umedoblock/freq-counter/pcb/images/freq-counter-pcb-pre-final.png

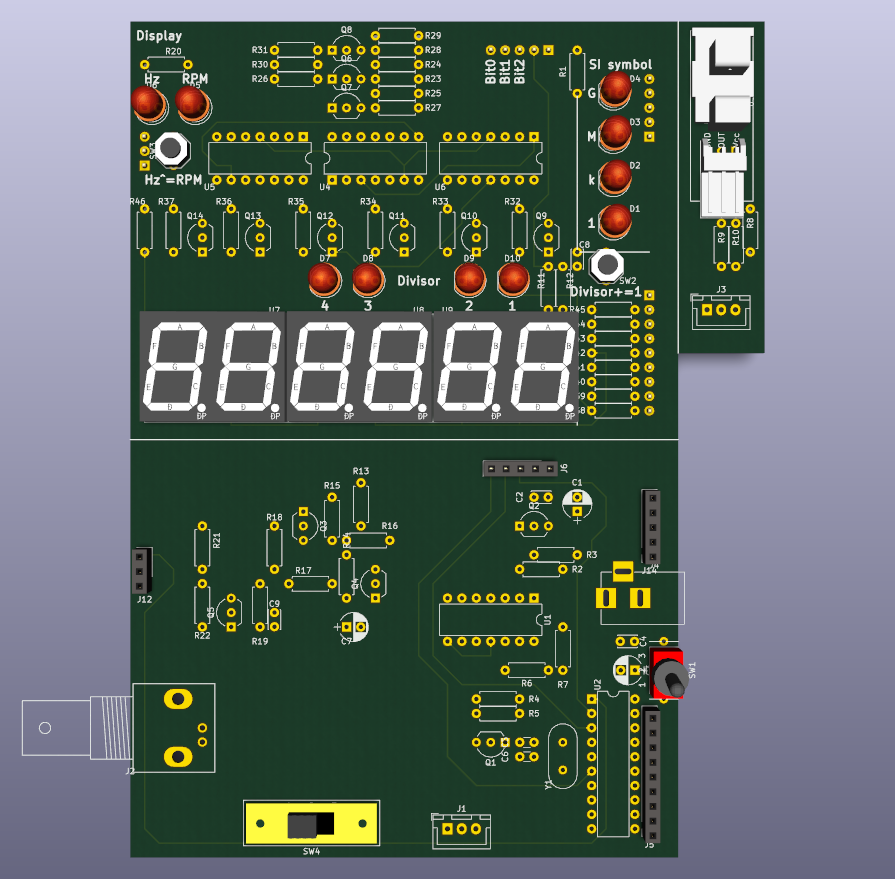
pcb/images/freq-counter-pcb-pre-final.png
