umedoblock/freq-counter/pcb/images/real-board-and-kicad-board.png

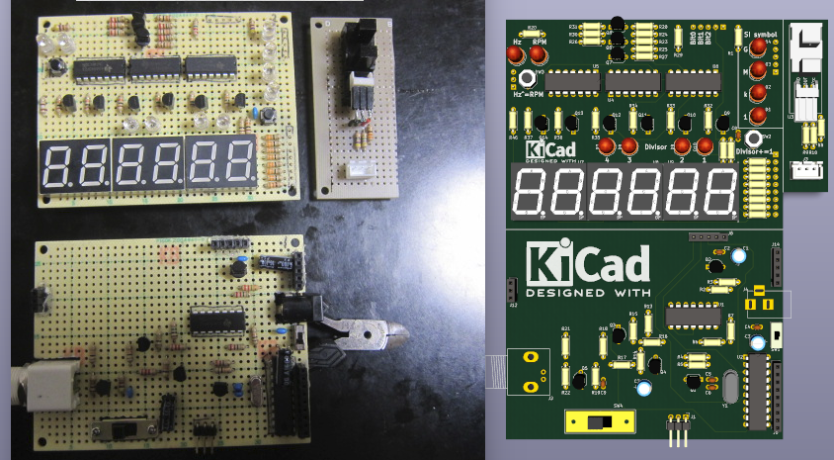
pcb/images/real-board-and-kicad-board.png
