umedoblock/freq-counter/README.md

# freq-counter
frequency counter with Attiny4313
