umedoblock/freq-counter/pcb/images/freq-counter-pcb-completed.png

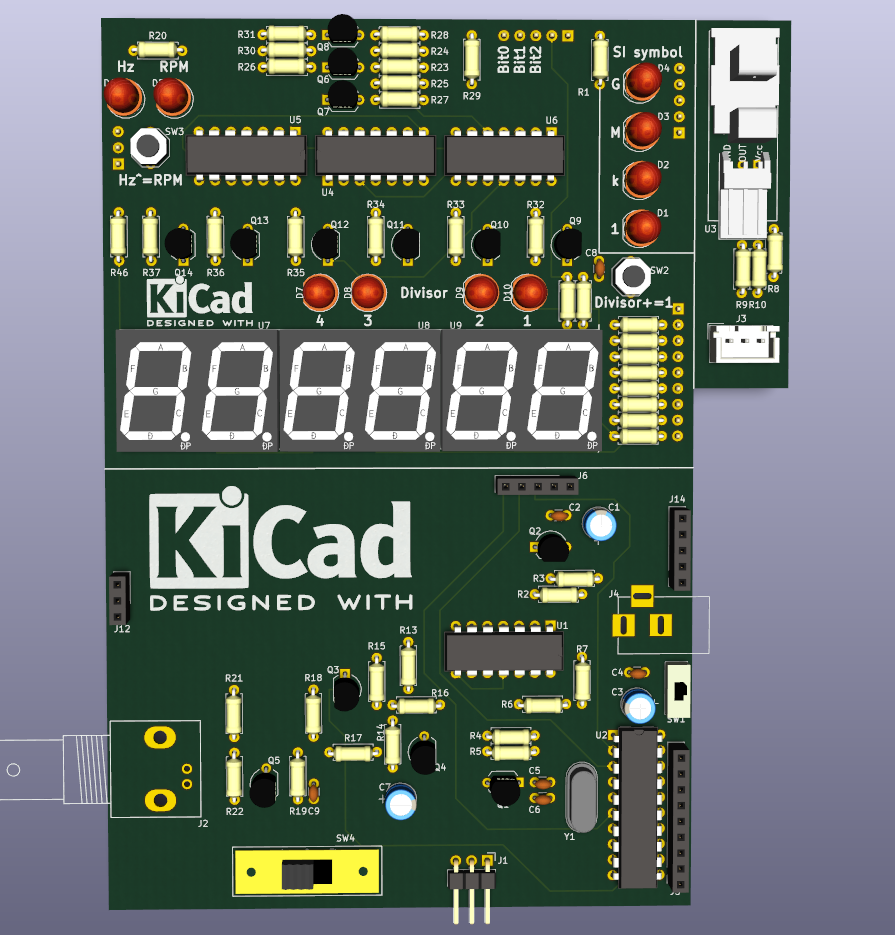
pcb/images/freq-counter-pcb-completed.png
