umedoblock/freq-counter/pcb/images/freq-counter-pcb-plain.png

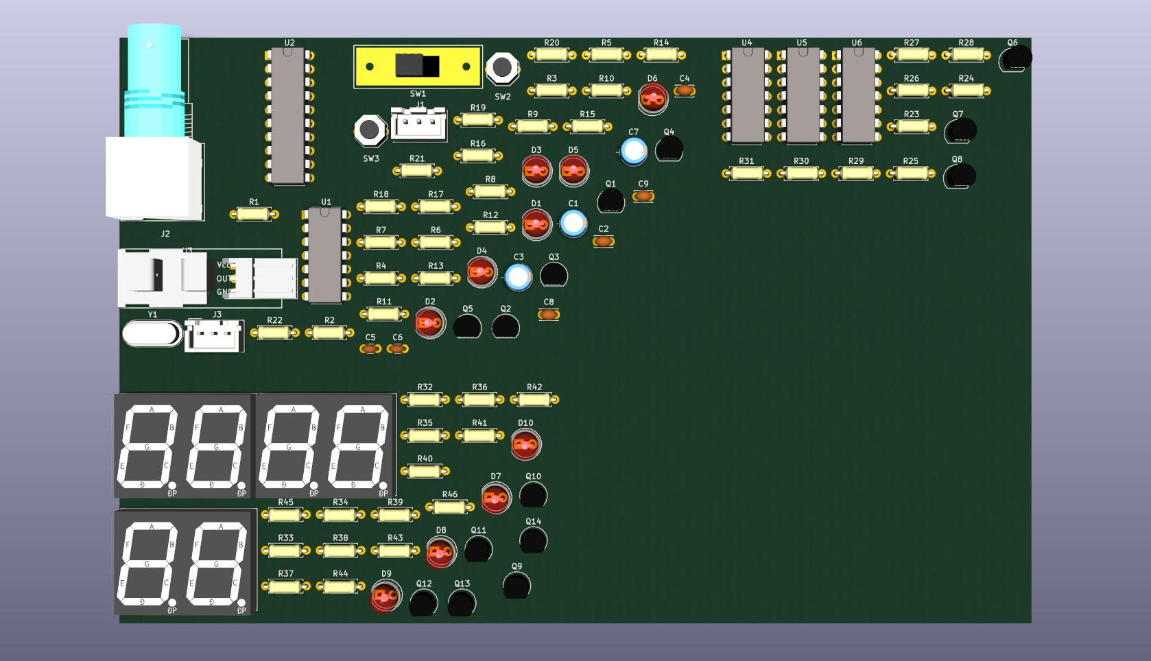
pcb/images/freq-counter-pcb-plain.png
