umedoblock/freq-counter/pcb/freq-counter.ods

Reference | Value | Footprint | Datasheet
C1 | 100u | Capacitor_THT:CP_Radial_D5.0mm_P2.50mm
C2 | 0.1u | Capacitor_THT:C_Disc_D3.0mm_W1.6mm_P2.50mm
C3 | 100u | Capacitor_THT:CP_Radial_D5.0mm_P2.50mm
C4 | 0.1u | Capacitor_THT:C_Disc_D3.0mm_W1.6mm_P2.50mm
C5 | 22p | Capacitor_THT:C_Disc_D3.0mm_W1.6mm_P2.50mm
C6 | 22p | Capacitor_THT:C_Disc_D3.0mm_W1.6mm_P2.50mm
C7 | 4.7u | Capacitor_THT:CP_Radial_D5.0mm_P2.50mm
C8 | 0.1u | Capacitor_THT:C_Disc_D3.0mm_W1.6mm_P2.50mm
C9 | 0.1u | Capacitor_THT:C_Disc_D3.0mm_W1.6mm_P2.50mm
D1 | 1 | LED_THT:LED_D5.0mm
D2 | k | LED_THT:LED_D5.0mm
D3 | M | LED_THT:LED_D5.0mm
D4 | G | LED_THT:LED_D5.0mm
D5 | RPM | LED_THT:LED_D5.0mm
D6 | Hz | LED_THT:LED_D5.0mm
D7 | 4 | LED_THT:LED_D5.0mm
D8 | 3 | LED_THT:LED_D5.0mm
D9 | 2 | LED_THT:LED_D5.0mm
D10 | 1 | LED_THT:LED_D5.0mm
J1 | RPM on board | Connector_PinHeader_2.54mm:PinHeader_1x03_P2.54mm_Horizontal
J2 | BNC | Connectors_TE-Connectivity:BNC_Socket_TYCO-AMP
J3 | RPM to Board | Connector_JST:JST_XH_B03B-XH-A_1x03_P2.50mm_Horizontal
J4 | Jack-DC | Connectors:BARREL_JACK
J5 | Segments-Terminal0 | Connector_PinSocket_2.54mm:PinSocket_1x09_P2.54mm_Vertical
J6 | Power-Digits_Terminal0 | Connector_PinSocket_2.54mm:PinSocket_1x05_P2.54mm_Vertical
J7 | Segments-Terminal1 | Connector_PinHeader_2.54mm:PinHeader_1x09_P2.54mm_Vertical
J8 | Power-Digits_Terminal1 | Connector_PinHeader_2.54mm:PinHeader_1x05_P2.54mm_Vertical
J11 | Hz/RPM_Terminal1 | Connector_PinHeader_2.54mm:PinHeader_1x03_P2.54mm_Vertical
J12 | Hz/RPM_Terminal0 | Connector_PinSocket_2.54mm:PinSocket_1x03_P2.54mm_Vertical
J13 | 1kMG_Terminal1 | Connector_PinHeader_2.54mm:PinHeader_1x05_P2.54mm_Vertical
J14 | 1kMG_Terminal0 | Connector_PinSocket_2.54mm:PinSocket_1x05_P2.54mm_Vertical
Q1 | CSC388A | TO_SOT_Packages_THT:TO-92_Inline_Wide
Q2 | CSC388A | TO_SOT_Packages_THT:TO-92_Inline_Wide
Q3 | 2SA1015 | TO_SOT_Packages_THT:TO-92_Inline_Wide
Q4 | 2SC1815 | TO_SOT_Packages_THT:TO-92_Inline_Wide
Q5 | 2SC1815 | TO_SOT_Packages_THT:TO-92_Inline_Wide
Q6 | CSC388A | TO_SOT_Packages_THT:TO-92_Inline_Wide
Q7 | CSC388A | TO_SOT_Packages_THT:TO-92_Inline_Wide
Q8 | CSC388A | TO_SOT_Packages_THT:TO-92_Inline_Wide
Q9 | 2SC1815 | TO_SOT_Packages_THT:TO-92_Inline_Wide
Q10 | 2SC1815 | TO_SOT_Packages_THT:TO-92_Inline_Wide
Q11 | 2SC1815 | TO_SOT_Packages_THT:TO-92_Inline_Wide
Q12 | 2SC1815 | TO_SOT_Packages_THT:TO-92_Inline_Wide
Q13 | 2SC1815 | TO_SOT_Packages_THT:TO-92_Inline_Wide
Q14 | 2SC1815 | TO_SOT_Packages_THT:TO-92_Inline_Wide
R1 | 470 | Resistors_THT:R_Axial_DIN0207_L6.3mm_D2.5mm_P7.62mm_Horizontal
R2 | 2.2M | Resistors_THT:R_Axial_DIN0207_L6.3mm_D2.5mm_P7.62mm_Horizontal
R3 | 2.2M | Resistors_THT:R_Axial_DIN0207_L6.3mm_D2.5mm_P7.62mm_Horizontal
R4 | 2.2M | Resistors_THT:R_Axial_DIN0207_L6.3mm_D2.5mm_P7.62mm_Horizontal
R5 | 10k | Resistors_THT:R_Axial_DIN0207_L6.3mm_D2.5mm_P7.62mm_Horizontal
R6 | 2.2M | Resistors_THT:R_Axial_DIN0207_L6.3mm_D2.5mm_P7.62mm_Horizontal
R7 | 10k | Resistors_THT:R_Axial_DIN0207_L6.3mm_D2.5mm_P7.62mm_Horizontal
R8 | 330 | Resistors_THT:R_Axial_DIN0207_L6.3mm_D2.5mm_P7.62mm_Horizontal
R9 | 47k | Resistors_THT:R_Axial_DIN0207_L6.3mm_D2.5mm_P7.62mm_Horizontal
R10 | 4.7M | Resistors_THT:R_Axial_DIN0207_L6.3mm_D2.5mm_P7.62mm_Horizontal
R11 | 100k | Resistors_THT:R_Axial_DIN0207_L6.3mm_D2.5mm_P7.62mm_Horizontal
R12 | 10k | Resistors_THT:R_Axial_DIN0207_L6.3mm_D2.5mm_P7.62mm_Horizontal
R13 | 1M | Resistors_THT:R_Axial_DIN0207_L6.3mm_D2.5mm_P7.62mm_Horizontal
R14 | 47k | Resistors_THT:R_Axial_DIN0207_L6.3mm_D2.5mm_P7.62mm_Horizontal
R15 | 100k | Resistors_THT:R_Axial_DIN0207_L6.3mm_D2.5mm_P7.62mm_Horizontal
R16 | 2.2k | Resistors_THT:R_Axial_DIN0207_L6.3mm_D2.5mm_P7.62mm_Horizontal
R17 | 2.2k | Resistors_THT:R_Axial_DIN0207_L6.3mm_D2.5mm_P7.62mm_Horizontal
R18 | 10k | Resistors_THT:R_Axial_DIN0207_L6.3mm_D2.5mm_P7.62mm_Horizontal
R19 | 4.7k | Resistors_THT:R_Axial_DIN0207_L6.3mm_D2.5mm_P7.62mm_Horizontal
R20 | 470 | Resistors_THT:R_Axial_DIN0207_L6.3mm_D2.5mm_P7.62mm_Horizontal
R21 | 10k | Resistors_THT:R_Axial_DIN0207_L6.3mm_D2.5mm_P7.62mm_Horizontal
R22 | 10k | Resistors_THT:R_Axial_DIN0207_L6.3mm_D2.5mm_P7.62mm_Horizontal
R23 | 10k | Resistors_THT:R_Axial_DIN0207_L6.3mm_D2.5mm_P7.62mm_Horizontal
R24 | 2.2M | Resistors_THT:R_Axial_DIN0207_L6.3mm_D2.5mm_P7.62mm_Horizontal
R25 | 2.2M | Resistors_THT:R_Axial_DIN0207_L6.3mm_D2.5mm_P7.62mm_Horizontal
R26 | 2.2M | Resistors_THT:R_Axial_DIN0207_L6.3mm_D2.5mm_P7.62mm_Horizontal
R27 | 10k | Resistors_THT:R_Axial_DIN0207_L6.3mm_D2.5mm_P7.62mm_Horizontal
R28 | 10k | Resistors_THT:R_Axial_DIN0207_L6.3mm_D2.5mm_P7.62mm_Horizontal
R29 | 2.2M | Resistors_THT:R_Axial_DIN0207_L6.3mm_D2.5mm_P7.62mm_Horizontal
R30 | 2.2M | Resistors_THT:R_Axial_DIN0207_L6.3mm_D2.5mm_P7.62mm_Horizontal
R31 | 2.2M | Resistors_THT:R_Axial_DIN0207_L6.3mm_D2.5mm_P7.62mm_Horizontal
R32 | 10k | Resistors_THT:R_Axial_DIN0207_L6.3mm_D2.5mm_P7.62mm_Horizontal
R33 | 10k | Resistors_THT:R_Axial_DIN0207_L6.3mm_D2.5mm_P7.62mm_Horizontal
R34 | 10k | Resistors_THT:R_Axial_DIN0207_L6.3mm_D2.5mm_P7.62mm_Horizontal
R35 | 10k | Resistors_THT:R_Axial_DIN0207_L6.3mm_D2.5mm_P7.62mm_Horizontal
R36 | 10k | Resistors_THT:R_Axial_DIN0207_L6.3mm_D2.5mm_P7.62mm_Horizontal
R37 | 10k | Resistors_THT:R_Axial_DIN0207_L6.3mm_D2.5mm_P7.62mm_Horizontal
R38 | 330 | Resistors_THT:R_Axial_DIN0207_L6.3mm_D2.5mm_P7.62mm_Horizontal
R39 | 33 | Resistors_THT:R_Axial_DIN0207_L6.3mm_D2.5mm_P7.62mm_Horizontal
R40 | 33 | Resistors_THT:R_Axial_DIN0207_L6.3mm_D2.5mm_P7.62mm_Horizontal
R41 | 33 | Resistors_THT:R_Axial_DIN0207_L6.3mm_D2.5mm_P7.62mm_Horizontal
R42 | 33 | Resistors_THT:R_Axial_DIN0207_L6.3mm_D2.5mm_P7.62mm_Horizontal
R43 | 33 | Resistors_THT:R_Axial_DIN0207_L6.3mm_D2.5mm_P7.62mm_Horizontal
R44 | 33 | Resistors_THT:R_Axial_DIN0207_L6.3mm_D2.5mm_P7.62mm_Horizontal
R45 | 33 | Resistors_THT:R_Axial_DIN0207_L6.3mm_D2.5mm_P7.62mm_Horizontal
R46 | 180 | Resistors_THT:R_Axial_DIN0207_L6.3mm_D2.5mm_P7.62mm_Horizontal
SW1 | on/off | freq-counter:SS12D01G4
SW2 | count up | freq-counter:TVDT18-tactile-switch
SW3 | toggle | freq-counter:TVDT18-tactile-switch
SW4 | SW_SIGNAL | freq-counter:Slide-switch-x2
U1 | SN74HC02N | Package_DIP:DIP-14_W7.62mm
U2 | ATTINY4313-PU(freq-counter) | Package_DIP:DIP-20_W7.62mm
U3 | EE-SX460 | freq-counter:EE-SX460-P1
U4 | 74HC00 | Package_DIP:DIP-14_W7.62mm
U5 | 74HC00 | Package_DIP:DIP-14_W7.62mm
U6 | 74HC00 | Package_DIP:DIP-14_W7.62mm
U7 | 7seg-2digit-ca | freq-counter:PARA_LIGHT-552SRD
U8 | 7seg-2digit-ca | freq-counter:PARA_LIGHT-552SRD
U9 | 7seg-2digit-ca | freq-counter:PARA_LIGHT-552SRD
Y1 | 20MHz | Crystal:Crystal_HC49-4H_Vertical
