umedoblock/freq-counter/pcb/freq-counter.kicad_pcb

## KiCad design pcb/freq-counter.kicad_pcb (2017-12-02)

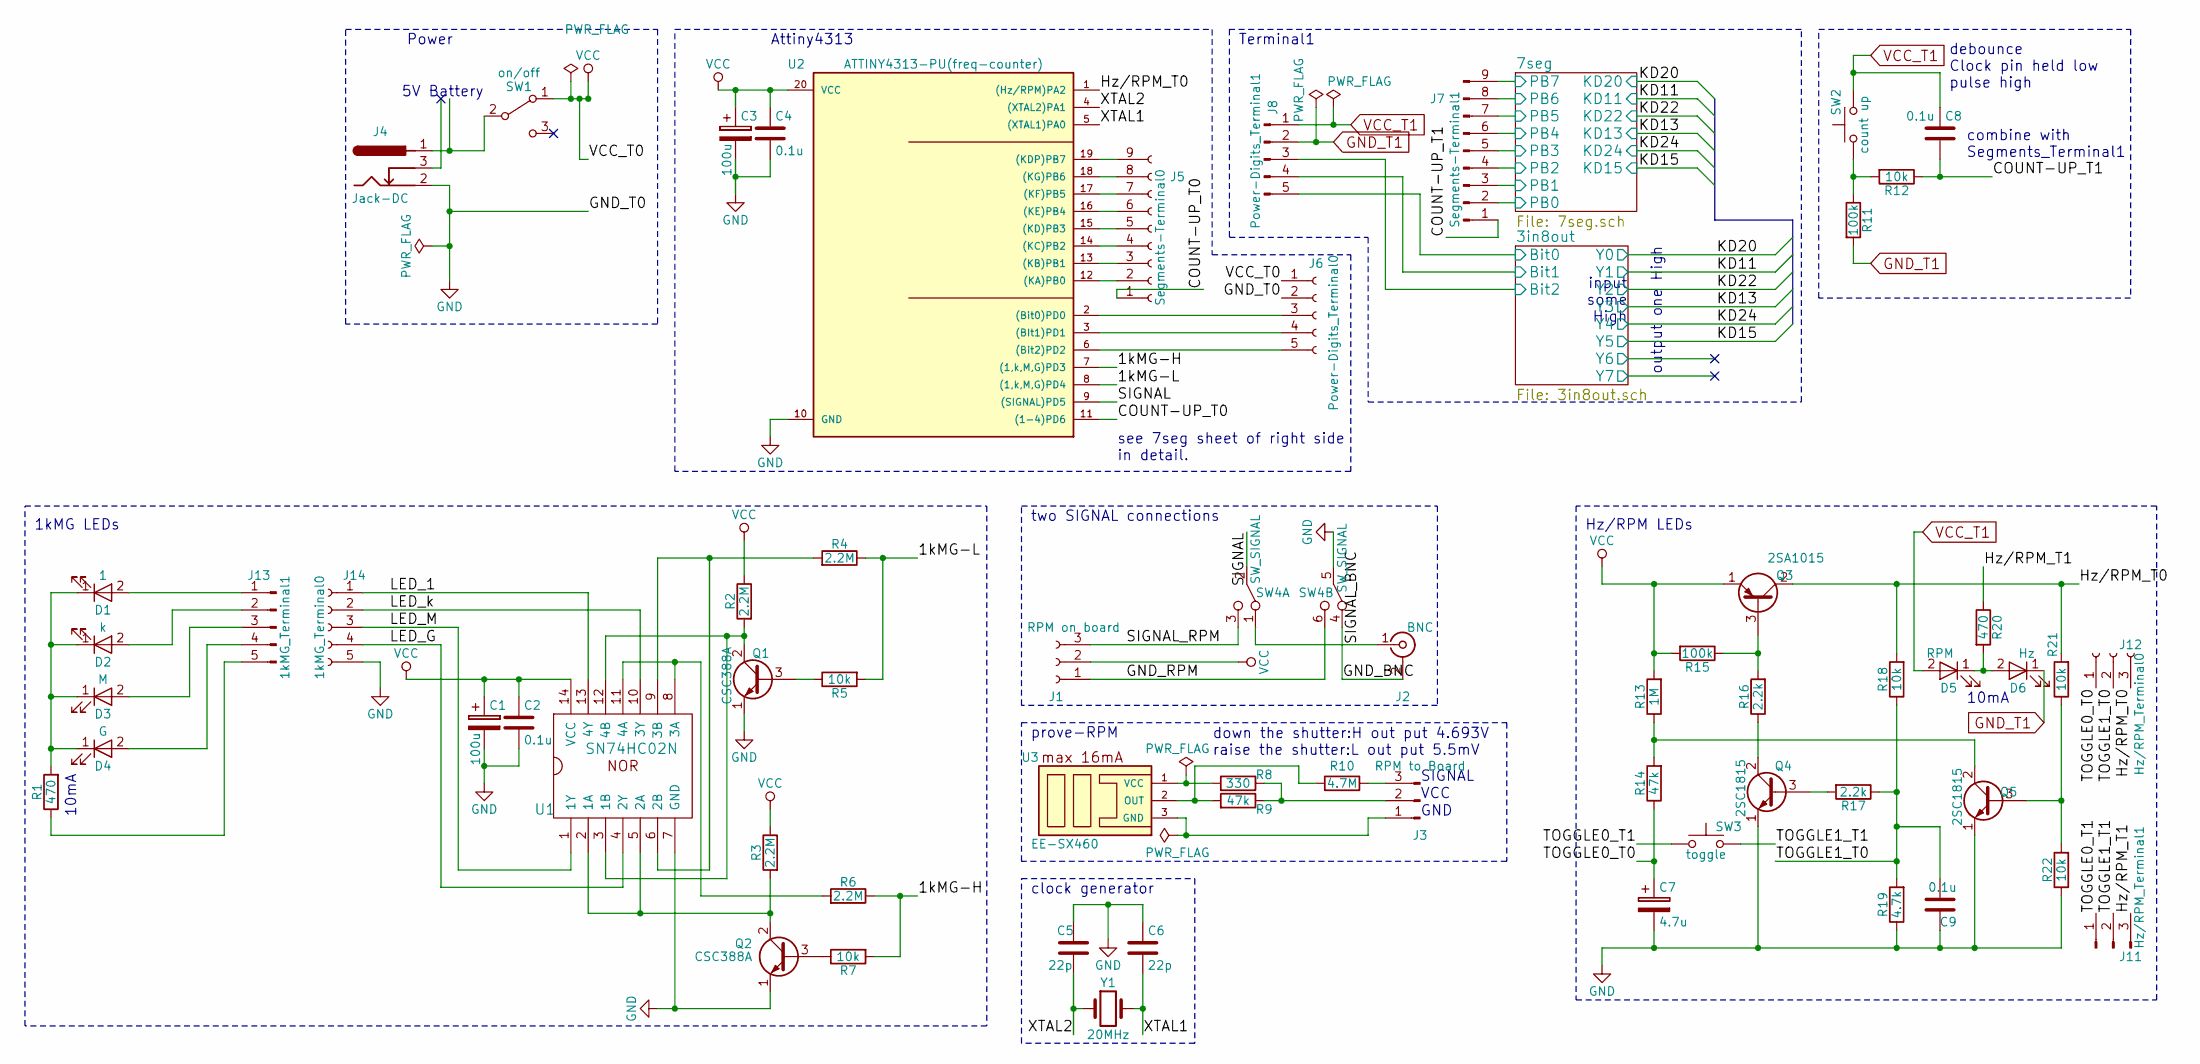
[picture p5: schematic freq-counter.sch]

Parts:
C1, C3: 100u; CP_Radial_D5.0mm_P2.50mm
C2, C4, C8, C9: 0.1u; C_Disc_D3.0mm_W1.6mm_P2.50mm
C5, C6: 22p; C_Disc_D3.0mm_W1.6mm_P2.50mm
C7: 4.7u; CP_Radial_D5.0mm_P2.50mm
D1: 1; LED_D5.0mm
D2: k; LED_D5.0mm
D3: M; LED_D5.0mm
D4: G; LED_D5.0mm
D5: RPM; LED_D5.0mm
D6: Hz; LED_D5.0mm
J1: RPM on board; PinHeader_1x03_P2.54mm_Horizontal
J2: BNC; BNC_Socket_TYCO-AMP
J3: RPM to Board; JST_XH_B03B-XH-A_03x2.50mm_Straight
J4: Jack-DC; BARREL_JACK
J5: Segments-Terminal0; PinSocket_1x09_P2.54mm_Vertical
J6: Power-Digits_Terminal0; PinSocket_1x05_P2.54mm_Vertical
J7: Segments-Terminal1; PinHeader_1x09_P2.54mm_Vertical
J8: Power-Digits_Terminal1; PinHeader_1x05_P2.54mm_Vertical
J11: Hz/RPM_Terminal1; PinHeader_1x03_P2.54mm_Vertical
J12: Hz/RPM_Terminal0; PinSocket_1x03_P2.54mm_Vertical
J13: 1kMG_Terminal1; PinHeader_1x05_P2.54mm_Vertical
J14: 1kMG_Terminal0; PinSocket_1x05_P2.54mm_Vertical
Q1, Q2: CSC388A; TO-92_Inline_Wide
Q3: 2SA1015; TO-92_Inline_Wide
Q4, Q5: 2SC1815; TO-92_Inline_Wide
R1, R20: 470; R_Axial_DIN0207_L6.3mm_D2.5mm_P7.62mm_Horizontal
R2, R3, R4, R6: 2.2M; R_Axial_DIN0207_L6.3mm_D2.5mm_P7.62mm_Horizontal
R5, R7, R12, R18, R21, R22: 10k; R_Axial_DIN0207_L6.3mm_D2.5mm_P7.62mm_Horizontal
R8: 330; R_Axial_DIN0207_L6.3mm_D2.5mm_P7.62mm_Horizontal
R9, R14: 47k; R_Axial_DIN0207_L6.3mm_D2.5mm_P7.62mm_Horizontal
R10: 4.7M; R_Axial_DIN0207_L6.3mm_D2.5mm_P7.62mm_Horizontal
R11, R15: 100k; R_Axial_DIN0207_L6.3mm_D2.5mm_P7.62mm_Horizontal
R13: 1M; R_Axial_DIN0207_L6.3mm_D2.5mm_P7.62mm_Horizontal
R16, R17: 2.2k; R_Axial_DIN0207_L6.3mm_D2.5mm_P7.62mm_Horizontal
R19: 4.7k; R_Axial_DIN0207_L6.3mm_D2.5mm_P7.62mm_Horizontal
SW1: on/off; SS12D01G4
SW2: count up; TVDT18-tactile-switch
SW3: toggle; TVDT18-tactile-switch
SW4: SW_SIGNAL; Slide-switch-x2
U1: SN74HC02N; DIP-14_W7.62mm
U2: ATTINY4313-PU(freq-counter); DIP-20_W7.62mm
U3: EE-SX460; EE-SX460-P1
Y1: 20MHz; Crystal_HC49-4H_Vertical

Connections:
/1kMG-H: R6.1, R7.2, U2.7 ((1,k,M,G)PD3)
/1kMG-L: R4.1, R5.2, U2.8 ((1,k,M,G)PD4)
/3in8out/Bit0: J8.5; also elsewhere on the board
/3in8out/Bit1: J8.4; also elsewhere on the board
/3in8out/Bit2: J8.3; also elsewhere on the board
/7seg/PB0: J7.2; also elsewhere on the board
/7seg/PB1: J7.3; also elsewhere on the board
/7seg/PB2: J7.4; also elsewhere on the board
/7seg/PB3: J7.5; also elsewhere on the board
/7seg/PB4: J7.6; also elsewhere on the board
/7seg/PB5: J7.7; also elsewhere on the board
/7seg/PB6: J7.8; also elsewhere on the board
/7seg/PB7: J7.9; also elsewhere on the board
/COUNT-UP_T0: J5.1, U2.11 ((1-4)PD6)
/COUNT-UP_T1: C8.2, J7.1, R12.1
/GND_BNC: J2.2 (Ext), SW4.4 (A)
/GND_RPM: J1.1, SW4.6 (C)
/Hz/RPM_T0: J12.3, Q3.2 (C), R18.2, R21.2, U2.1 ((Hz/RPM)PA2)
/Hz/RPM_T1: J11.3, R20.1
/LED_1: J14.1, U1.13 (4Y)
/LED_G: J14.4, U1.4 (2Y)
/LED_M: J14.3, U1.1 (1Y)
/LED_k: J14.2, U1.10 (3Y)
/SIGNAL: SW4.2 (B), U2.9 ((SIGNAL)PD5)
/SIGNAL_BNC: J2.1 (In), SW4.1 (A)
/SIGNAL_RPM: J1.3, SW4.3 (C)
/TOGGLE0_T0: C7.1, J12.1, R14.1
/TOGGLE0_T1: J11.1, SW3.1
/TOGGLE1_T0: C9.2, J12.2, R17.1, R18.1, R19.2
/TOGGLE1_T1: J11.2, SW3.2
/XTAL1: C6.2, U2.5 ((XTAL1)PA0), Y1.2
/XTAL2: C5.2, U2.4 ((XTAL2)PA1), Y1.1
GND: C1.2, C2.2, C3.2, C4.2, C5.1, C6.1, C7.2, C9.1, J4.2, J6.2, J14.5, Q1.1 (E), Q2.1 (E), Q4.1 (E), Q5.1 (E), R19.1, R22.1, SW4.5 (B), U1.7 (GND), U2.10 (GND)
GND_T1: D6.1 (K), J8.2, R11.2; also elsewhere on the board
unnamed: D1.1 (K), D2.1 (K), D3.1 (K), D4.1 (K), R1.2
unnamed: D1.2 (A), J13.1
unnamed: D2.2 (A), J13.2
unnamed: D3.2 (A), J13.3
unnamed: D4.2 (A), J13.4
unnamed: D5.1 (K), D6.2 (A), R20.2
unnamed: J3.1, U3.3 (GND)
unnamed: J3.2, R8.1, R9.1
unnamed: J3.3, R10.1
unnamed: J4.1, SW1.2 (B)
unnamed: J5.2, U2.12 ((KA)PB0)
unnamed: J5.3, U2.13 ((KB)PB1)
unnamed: J5.4, U2.14 ((KC)PB2)
unnamed: J5.5, U2.15 ((KD)PB3)
unnamed: J5.6, U2.16 ((KE)PB4)
unnamed: J5.7, U2.17 ((KF)PB5)
unnamed: J5.8, U2.18 ((KG)PB6)
unnamed: J5.9, U2.19 ((KDP)PB7)
unnamed: J6.3, U2.2 ((Bit0)PD0)
unnamed: J6.4, U2.3 ((BIt1)PD1)
unnamed: J6.5, U2.6 ((Bit2)PD2)
unnamed: J13.5, R1.1
unnamed: Q1.2 (C), R2.2, U1.3 (1B), U1.12 (4B)
unnamed: Q1.3 (B), R5.1
unnamed: Q2.2 (C), R3.2, U1.2 (1A), U1.5 (2A)
unnamed: Q2.3 (B), R7.1
unnamed: Q3.3 (B), R15.1, R16.2
unnamed: Q4.2 (C), R16.1
unnamed: Q4.3 (B), R17.2
unnamed: Q5.2 (C), R13.1, R14.2
unnamed: Q5.3 (B), R21.1, R22.2
unnamed: R4.2, U1.6 (2B), U1.9 (3B)
unnamed: R6.2, U1.8 (3A), U1.11 (4A)
unnamed: R8.2, U3.1 (VCC)
unnamed: R9.2, R10.2, U3.2 (OUT)
unnamed: R11.1, R12.2, SW2.1
VCC: C1.1, C2.1, C3.1, C4.1, J1.2, J6.1, Q3.1 (E), R2.1, R3.1, R13.2, R15.2, SW1.1 (A), U1.14 (VCC), U2.20 (VCC)
VCC_T1: C8.1, D5.2 (A), J8.1, SW2.2; also elsewhere on the board

Notes on the sheet:
debounce Clock pin held low pulse high
Hz/RPM LEDs
1kMG LEDs
10mA
output one High
input some High
see 7seg sheet of right side in detail.
Attiny4313
clock generator
prove-RPM
two SIGNAL connections
SIGNAL
VCC
GND
down the shutter:H out put 4.693V raise the shutter:L out put 5.5mV
Power
5V Battery
Terminal1
combine with Segments_Terminal1

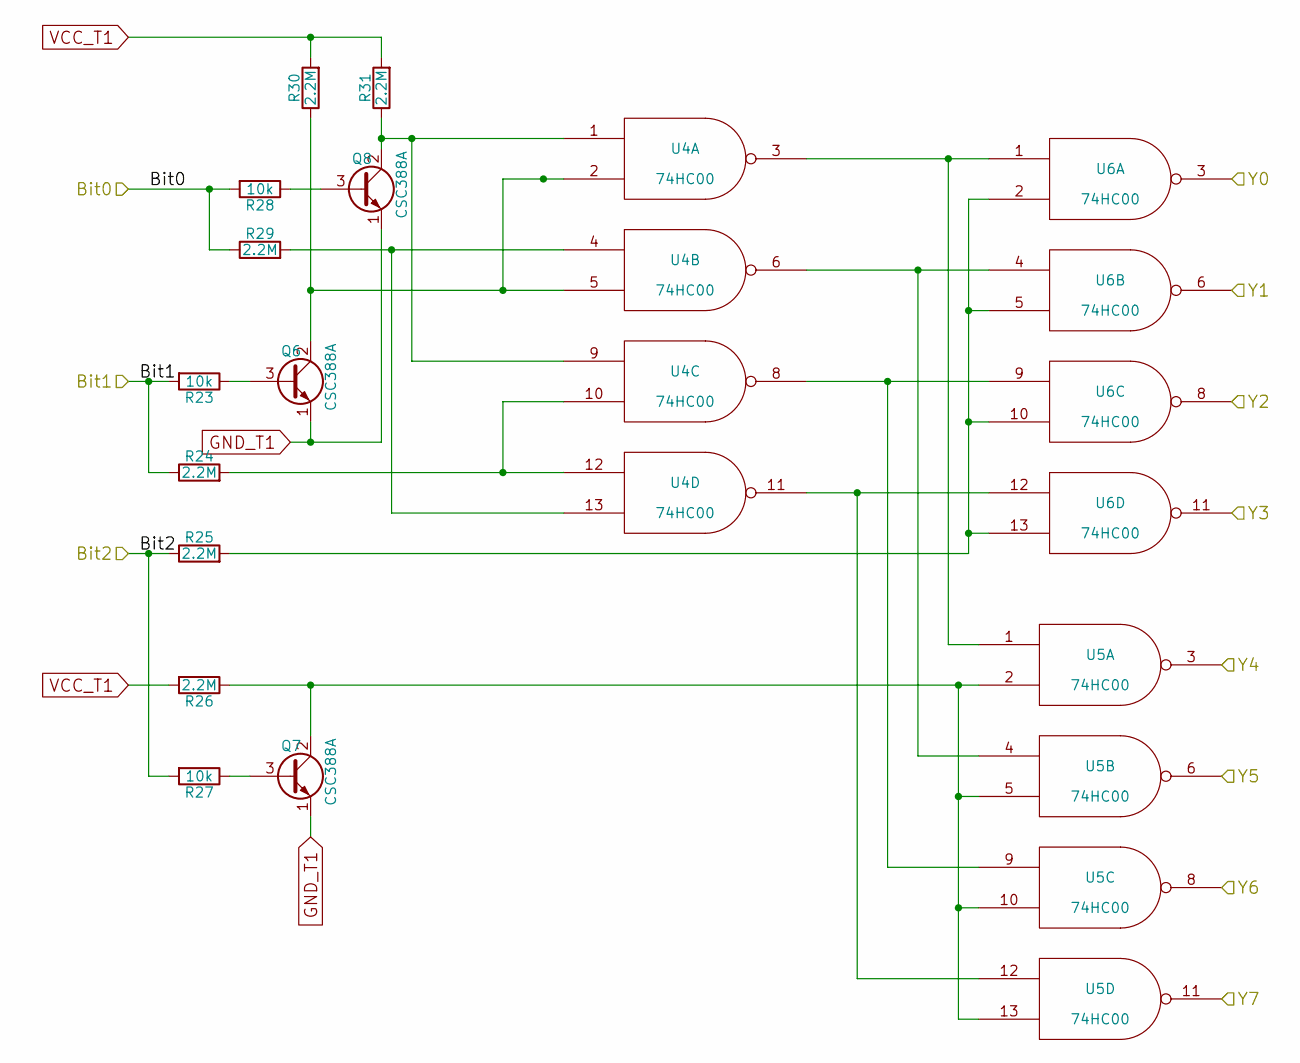
[picture p6: schematic 3in8out.sch]

Parts:
Q6, Q7, Q8: CSC388A; TO-92_Inline_Wide
R23, R27, R28: 10k; R_Axial_DIN0207_L6.3mm_D2.5mm_P7.62mm_Horizontal
R24, R25, R26, R29, R30, R31: 2.2M; R_Axial_DIN0207_L6.3mm_D2.5mm_P7.62mm_Horizontal
U4, U5, U6: 74HC00; DIP-14_W7.62mm

Connections:
/3in8out/Bit0: R28.2, R29.1; also elsewhere on the board
/3in8out/Bit1: R23.2, R24.1; also elsewhere on the board
/3in8out/Bit2: R25.1, R27.2; also elsewhere on the board
/KD11: U6.6; also elsewhere on the board
/KD13: U6.11; also elsewhere on the board
/KD15: U5.6; also elsewhere on the board
/KD20: U6.3; also elsewhere on the board
/KD22: U6.8; also elsewhere on the board
/KD24: U5.3; also elsewhere on the board
GND_T1: Q6.1 (E), Q7.1 (E), Q8.1 (E), U4.7 (GND_T1), U5.7 (GND_T1), U6.7 (GND_T1); also elsewhere on the board
unnamed: Q6.2 (C), R30.1, U4.2, U4.5
unnamed: Q6.3 (B), R23.1
unnamed: Q7.2 (C), R26.1, U5.2, U5.5, U5.10, U5.13
unnamed: Q7.3 (B), R27.1
unnamed: Q8.2 (C), R31.1, U4.1, U4.9
unnamed: Q8.3 (B), R28.1
unnamed: R24.2, U4.10, U4.12
unnamed: R25.2, U6.2, U6.5, U6.10, U6.13
unnamed: R29.2, U4.4, U4.13
unnamed: U4.3, U5.1, U6.1
unnamed: U4.6, U5.4, U6.4
unnamed: U4.8, U5.9, U6.9
unnamed: U4.11, U5.12, U6.12
VCC_T1: R26.2, R30.2, R31.2, U4.14 (VCC_T1), U5.14 (VCC_T1), U6.14 (VCC_T1); also elsewhere on the board

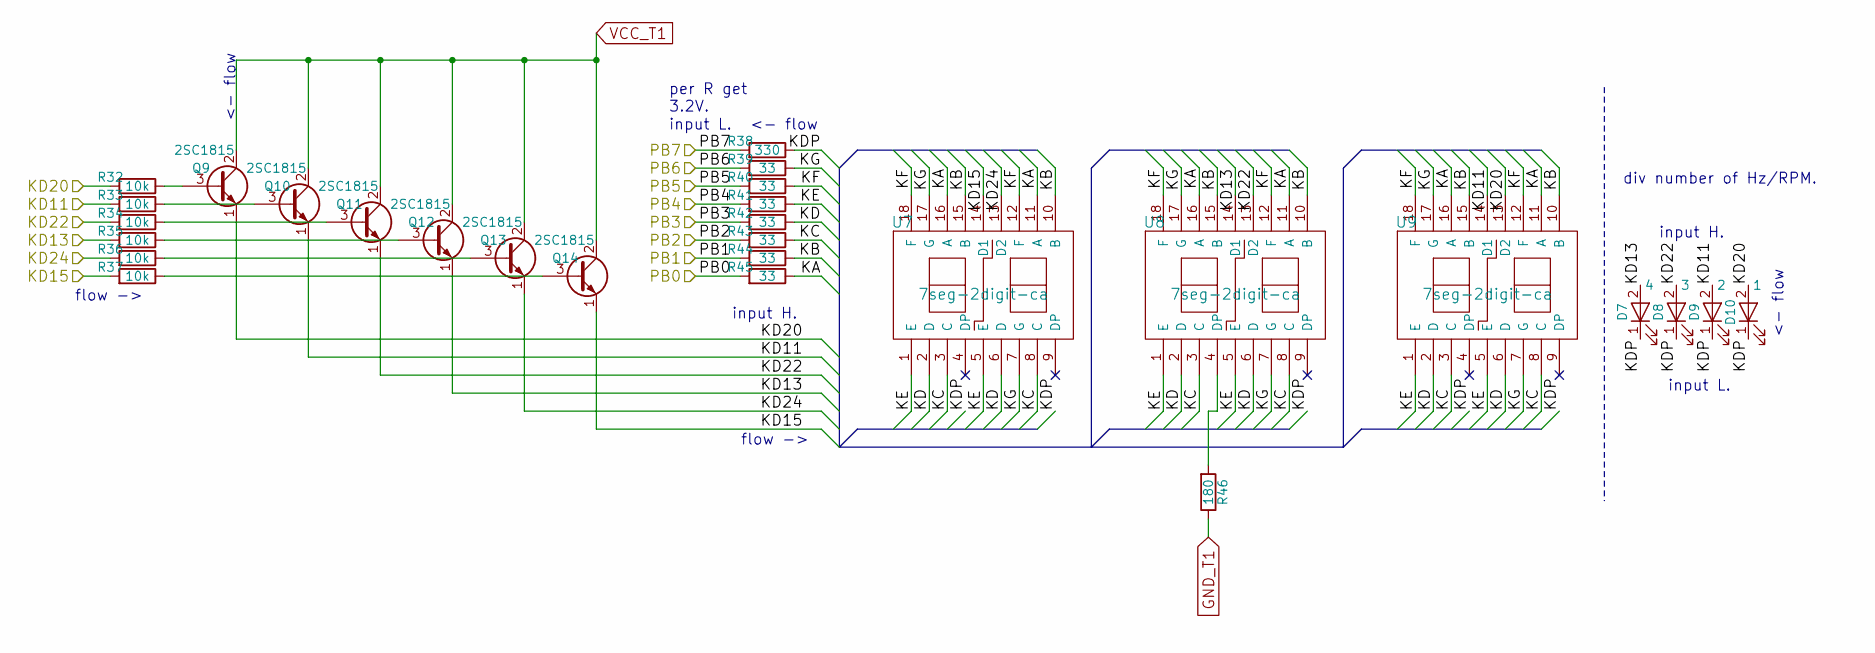
[picture p7: schematic 7seg.sch]

Parts:
D7: 4; LED_D5.0mm
D8: 3; LED_D5.0mm
D9: 2; LED_D5.0mm
D10: 1; LED_D5.0mm
Q9, Q10, Q11, Q12, Q13, Q14: 2SC1815; TO-92_Inline_Wide
R32, R33, R34, R35, R36, R37: 10k; R_Axial_DIN0207_L6.3mm_D2.5mm_P7.62mm_Horizontal
R38: 330; R_Axial_DIN0207_L6.3mm_D2.5mm_P7.62mm_Horizontal
R39, R40, R41, R42, R43, R44, R45: 33; R_Axial_DIN0207_L6.3mm_D2.5mm_P7.62mm_Horizontal
R46: 180; R_Axial_DIN0207_L6.3mm_D2.5mm_P7.62mm_Horizontal
U7, U8, U9: 7seg-2digit-ca; PARA_LIGHT-552SRD

Connections:
/7seg/KA: R45.1, U7.11 (A), U7.16 (A), U8.11 (A), U8.16 (A), U9.11 (A), U9.16 (A)
/7seg/KB: R44.1, U7.10 (B), U7.15 (B), U8.10 (B), U8.15 (B), U9.10 (B), U9.15 (B)
/7seg/KC: R43.1, U7.3 (C), U7.8 (C), U8.3 (C), U8.8 (C), U9.3 (C), U9.8 (C)
/7seg/KD: R42.1, U7.2 (D), U7.6 (D), U8.2 (D), U8.6 (D), U9.2 (D), U9.6 (D)
/7seg/KDP: D7.1 (K), D8.1 (K), D9.1 (K), D10.1 (K), R38.1
/7seg/KE: R41.1, U7.1 (E), U7.5 (E), U8.1 (E), U8.5 (E), U9.1 (E), U9.5 (E)
/7seg/KF: R40.1, U7.12 (F), U7.18 (F), U8.12 (F), U8.18 (F), U9.12 (F), U9.18 (F)
/7seg/KG: R39.1, U7.7 (G), U7.17 (G), U8.7 (G), U8.17 (G), U9.7 (G), U9.17 (G)
/7seg/PB0: R45.2; also elsewhere on the board
/7seg/PB1: R44.2; also elsewhere on the board
/7seg/PB2: R43.2; also elsewhere on the board
/7seg/PB3: R42.2; also elsewhere on the board
/7seg/PB4: R41.2; also elsewhere on the board
/7seg/PB5: R40.2; also elsewhere on the board
/7seg/PB6: R39.2; also elsewhere on the board
/7seg/PB7: R38.2; also elsewhere on the board
/KD11: D9.2 (A), Q10.1 (E), R33.2, U9.14 (D1); also elsewhere on the board
/KD13: D7.2 (A), Q12.1 (E), R35.2, U8.14 (D1); also elsewhere on the board
/KD15: Q14.1 (E), R37.2, U7.14 (D1); also elsewhere on the board
/KD20: D10.2 (A), Q9.1 (E), R32.2, U9.13 (D2); also elsewhere on the board
/KD22: D8.2 (A), Q11.1 (E), R34.2, U8.13 (D2); also elsewhere on the board
/KD24: Q13.1 (E), R36.2, U7.13 (D2); also elsewhere on the board
GND_T1: R46.1; also elsewhere on the board
unnamed: Q9.3 (B), R32.1
unnamed: Q10.3 (B), R33.1
unnamed: Q11.3 (B), R34.1
unnamed: Q12.3 (B), R35.1
unnamed: Q13.3 (B), R36.1
unnamed: Q14.3 (B), R37.1
unnamed: R46.2, U8.4 (DP)
VCC_T1: Q9.2 (C), Q10.2 (C), Q11.2 (C), Q12.2 (C), Q13.2 (C), Q14.2 (C); also elsewhere on the board

Notes on the sheet:
per R get 3.2V.
div number of Hz/RPM.
input L.
input H.
flow ->
<- flow

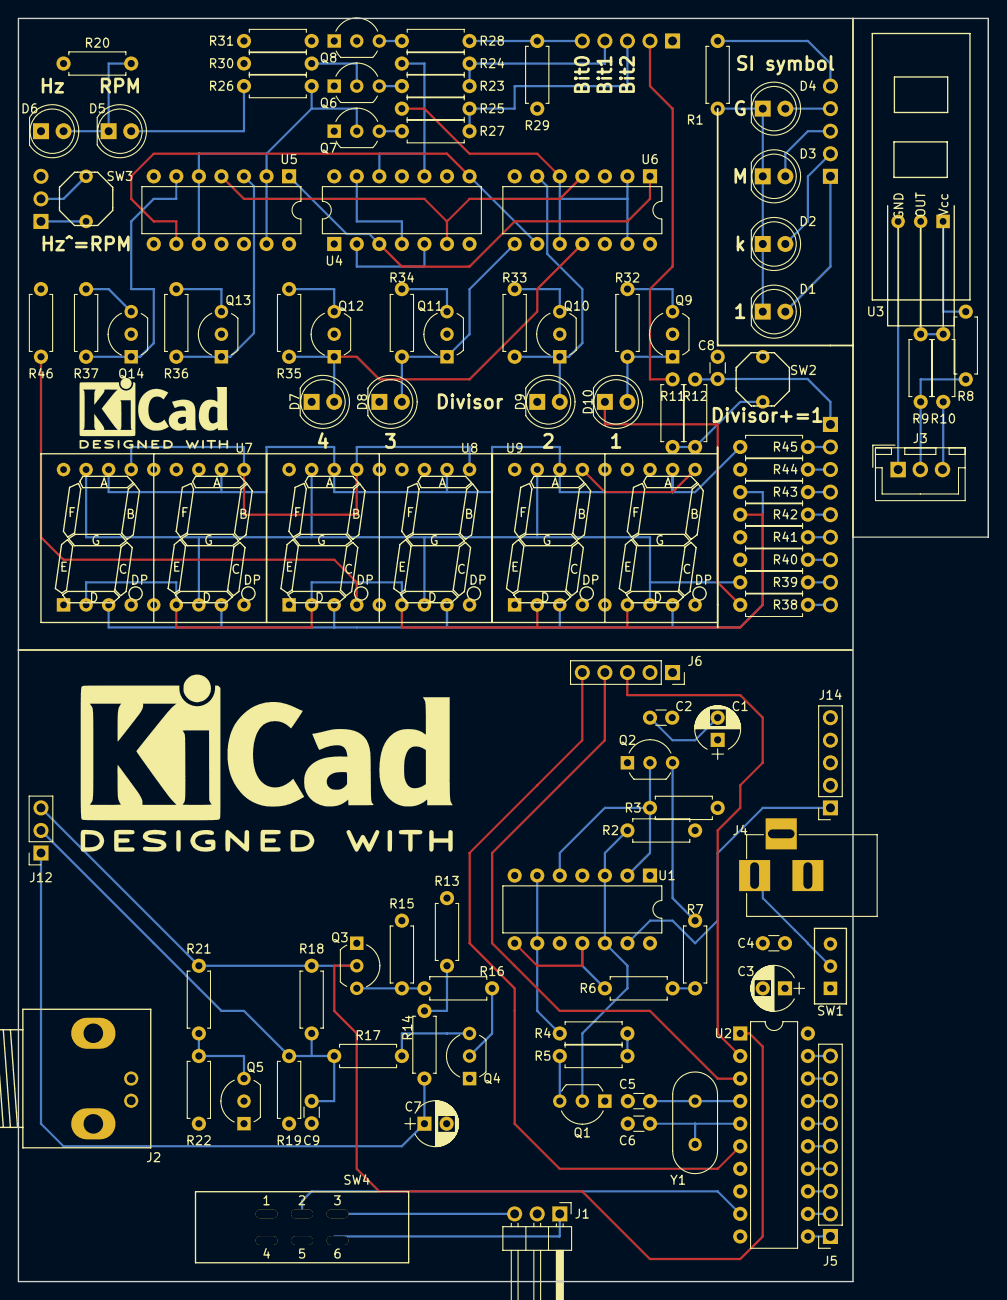
[picture p8: board freq-counter.kicad_pcb from above]

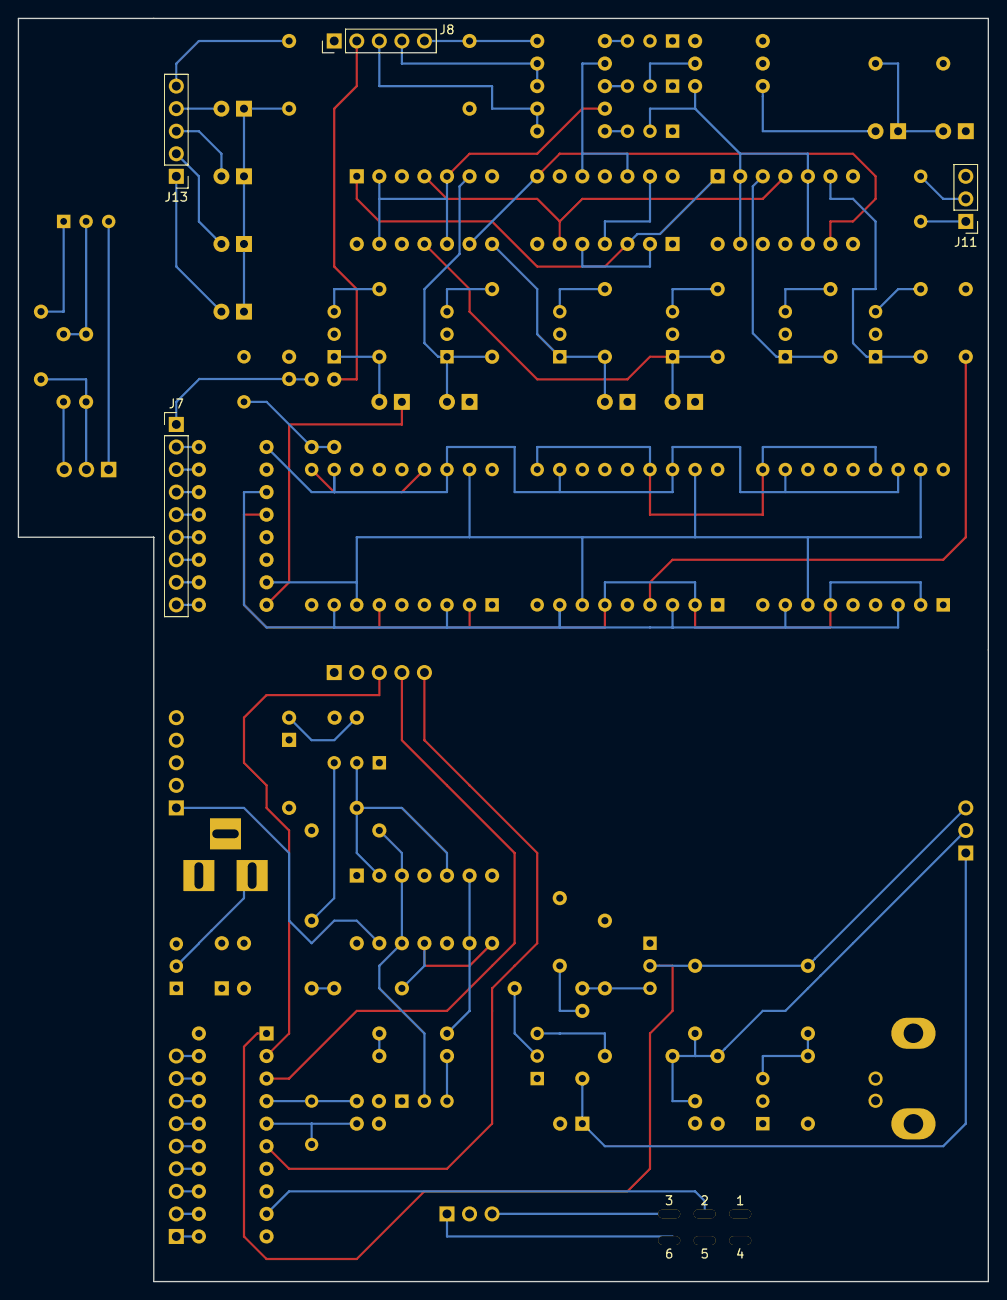
[picture p9: board freq-counter.kicad_pcb from below]

Board: 4 copper layers, 109.2 x 142.2 mm, 105 parts (4 on the bottom side), 106 nets.
