umedoblock/freq-counter/(commit log)

2017-11-17 Attiny4313 の pin assign.
    [attiny4313.ods]
2017-11-17 3入力8出力を大雑把に書いた。
    [freq-counter.sch]
2017-11-18 tempolary save.
    [freq-counter.kicad_pcb]
2017-11-18 3入力8出力回路を書いた。8出力の内，6出力は7segの各桁に対応するよう繋いだ。
    残りの2出力は未結線とした。
    [Digits6.sch, freq-counter.sch]
2017-11-18 7seg に関する部分をsheetに分割。
    [3in8out.sch, 7seg.sch, freq-counter.sch]
2017-11-18 change arrangement.
    [7seg.sch, freq-counter.sch]
2017-11-18 7seg の DIG-1,2 を 2SC1815 経由で VCC と繋ぐようにした。
    最初は TVCC と DIG-1,2 の接続にしていたが，7segで100mA消費すると仮定すると，
    回路全体で150mA中の130mA使用する計算になり，残りの電流が20mA程度になってしまう。
    なぜならば，thyristor を構成する2SA1015, 2SC1815で供給出来る電流を150mAと
    計算しているから。
    [7seg.sch]
2017-11-18 write clock generator.
    [freq-counter.sch]
2017-11-18 透過型フォト・マイクロセンサ EE-SX460 を追加。
2017-11-18 add explain "max 16mA".
2017-11-18 write just SIGNAL of photo interrupt block.
    [freq-counter.sch]
2017-11-19 SIGNAL を BNC端子 に接続することにした。
    [freq-counter.sch]
2017-11-19 determined two type connections to SIGNAL.
    [freq-counter.sch]
2017-11-19 prove-RPM 回路の定数を決定。
    [freq-counter.sch]
2017-11-19 1kMG LEDs の LED に使用する抵抗を一つのみにした。
    1kMGのLEDの内，一つのみ光るから，4個も必要ない。
    [freq-counter.sch]
2017-11-19 clock-generator の図に隙間が空いていて美しくなかったので，引き締めた。
    [freq-counter.sch]
2017-11-19 block diagram の配置を微調整。
    [freq-counter.sch]
2017-11-19 add Power part and pass con to Attiny4313 of VCC.
    [freq-counter.sch]
2017-11-19 7seg sheet に TVCC を global label として設定。
    [7seg.sch]
2017-11-19 add global label of "TVCC" in Power part.
    [freq-counter.sch]
2017-11-19 wire に未接続の設定をしていたら文句を言われたので，wireの未接続を削除。
    [7seg.sch, freq-counter.sch]
2017-11-19 細々した配線誤りを修正。 fixed tiny mistake.
    [3in8out.sch, freq-counter.sch]
2017-11-20 add footprint of PARA_LIGHT_CA 551/552 SRD.
2017-11-20 EE-SX460-P1 の footprint を書いた。
2017-11-21 mini mini universal board.
2017-11-22 add legs to 551SR-C/A.
2017-11-22 Para light 552SR の model も書いた。
2017-11-22 segment の色がおかしかったので修正。
2017-11-22 とりあえず，押しボタン部分と胴体が基板に正しい大きさで接地する。
2017-11-22 add Tactile model and footprint.
2017-11-22 ee-sx640 の 3D model の get 方法を書いた。
2017-11-22 全ての部品を展開しただけの状態。
2017-11-22 slide switch 3D model.
2017-11-22 OMRON 提供の EE-SX460 の 3D に合わせて，縮尺・回転・off set を適切に調整した。
2017-11-22 抵抗を 6.3mm の 1 / 4 W の抵抗に変更。
    [7seg.sch]
2017-11-22 3in8out 回路に CvPcb で部品を割り当てた。
    [3in8out.sch]
2017-11-22 CvPcb で main 基板に部品を割り当てた。
    [freq-counter.sch]
2017-11-22 KiCad が自動的に修正。
2017-11-22 PcbNew で全ての部品を展開した状態。他は何もしていない。
    [freq-counter.kicad_pcb]
2017-11-23 P1 <=> P11 の入れ替え。P1をHz/RPMの入力用PIN。P11を1-4のcount up PIN にした。
    他に，P1, 19,-12, 2,3,6,7,8を入力PINに設定。何故か，入出力になっていた。
2017-11-24 2SC1815 の footprint を，足の間隔が0.1inchのfootprintに変更。
    [7seg.sch]
2017-11-24 uni板は，24x31 のuni板を作成。2桁7SEGは，中央の縦線を削除。
    2桁7SEGでは，上下を水平に走る線を2本から1本に変更。
2017-11-24 2SC1815 のfootprintを，足の感覚が0.1inchであるfootprintに変更。
    [3in8out.sch]
2017-11-24 P1 <=> P11 の入れ替え。P7<=>P8の入れ替え。
    詳細は以下の通り。
    1 PA2 Hz/RPM入力
    11 PD6 1/2/3/4切り替え
    7 PD3 '1/k/M/G表示 H
    8 PD4 '1/k/M/G表示 L
    [attiny4313.ods]
2017-11-24 P2,3,6-8,12-19を入力PINに設定。P7<->P8を入れ替え。P1<->P11を入れ替え。
    P1をHz/RPMの入力用に。P11をDivisor(1-4)用に設定。
    P7を1,k,M,GのHに。P8を1,k,M,GのLに設定。
2017-11-24 変更点多し。
    修正は色々よ。色々。
    [freq-counter.sch]
2017-11-24 基板の配線を9割ぐらい終えた。現状では，基板の実装面積が大きくなり困っている。
    機能毎に複数階にしようか検討中。各回はcableで繋ぐことを想定している。
    [freq-counter.kicad_pcb]
2017-11-24 D5 と接続する"TVCC"の向きを垂直から水平に修正。
    [freq-counter.sch]
2017-11-25 RPM, BNCのGND線とSIGNAL線をSW_DPDTで物理的に切り離すようにした。
    [freq-counter.sch]
2017-11-25 tow SIGNAL connections の配置を修正。その他，見栄えを良くするための整形をした。
    [freq-counter.sch]
2017-11-25 回路図の見栄えを良くするために，リファレンスを回転させたり移動させたり。
    [freq-counter.sch]
2017-11-25 SW4A,SW4Bの定数が異なっていたので，"SW_SIGNAL"に統一。
    [freq-counter.sch]
2017-11-25 "SW4" "SW_SIGNAL" に，"freq-counter:Slide-switch" を割り当てた。
    [freq-counter.sch]
2017-11-25 slide switch の footprint を 3x2に修正。 3x1は間違いだった。
2017-11-25 slide switch を2回路2接点に修正。
    私の手持ちのslide switchは2回路2接点だったため。
    [freq-counter.kicad_pcb, freq-counter.sch]
2017-11-25 slide switchを2回路2接点に修正。
2017-11-26 ignore stl file.
2017-11-28 make Toggle switch of footprint and 3D model.
2017-11-28 auto changed by kicad.
2017-11-28 add three legs to toggle switch.
2017-11-28 "freq-counter:SW_Toggle_x1" を SW1(on/off) として採用。
    [freq-counter.sch]
2017-11-28 SW1(on/off), SW4(GND,SIGNAL)を基板上に仮配置した。
    [freq-counter.kicad_pcb]
2017-11-28 SW4Aの1-3, SW4Bの4-6の配線をそれぞれ繋ぎ変え。それらの配線にlabelを設定。
    基板実装上，入れ替えたほうがslideの操作が直感的であったため。
    PcbnewでSW4A,SW4Bの配線が何の意味の配線か分かりにくかったため以下のlabelを設定。
    1: SIGNAL_BNC
    3: SIGNAL_RPM
    4: GND_BNC
    6: GND_RPM
    [freq-counter.sch]
2017-11-28 SW4(SW_SIGNAL) の1-3, 4-6の配線を入れ替え。
    [freq-counter.kicad_pcb]
2017-11-28 U2(Attiny4313)の8PINのlabel名を1kMG-Lに修正。いつの間にか変わっていた。
    [freq-counter.sch]
2017-11-28 U2(Attiny4313)の8PINのlabel名を1kMG-Lに修正。
    いつの間にか変わっていた。。。
    [freq-counter.kicad_pcb]
2017-11-29 J3(EE-SX460) を別基板に切り分けて実装した。RPMの計測用sensor。
    [freq-counter.kicad_pcb, freq-counter.sch]
2017-11-29 RPM 用基板を母基板にくっつけた。
    [freq-counter.kicad_pcb]
2017-11-29 Bit0, Bit1, Bit2 のlabelを振った。
    [3in8out.sch]
2017-11-29 基本的に入出力に関する，7SEG, LED, PUSH-BUTTONを2階に配置する。
    2階-1階の直登戦術でいこうと思う。
    [3in8out.sch, 7seg.sch, freq-counter.kicad_pcb, freq-counter.sch]
2017-11-29 4 layer に設定。In1.Cuがjumper layer，In2.Cuが電源layer。
    [freq-counter.kicad_pcb]
2017-11-29 7SEG, LED, PUSH-BUTTON 等の入出力関係は上部に移動させた。
    [freq-counter.kicad_pcb]
2017-11-29 74HC00系用に，VCC_T1, GND_T1を作成。
    母板と74HC00をconnectorで分離したかったため，xxx_T1を作成する必要があった。
    [3in8out.sch, freq-counter.kicad_pcb, freq-counter.sch]
2017-11-29 ERC 走らせたら，いくつか error を指摘されたので修正。
    [7seg.sch, freq-counter.sch]
2017-11-29 TVCC, TGND の壊滅。
    [freq-counter.kicad_pcb, freq-counter.sch]
2017-11-29 4色駆使することで，なんとかかんとか7SEG, LEDの配線が完成。
    [freq-counter.kicad_pcb]
2017-11-29 Display 部を時計回りに90度回転させて，mother部とくっつけた。
    なんとか，2階建てで上手くいきそうな気がする。
    [freq-counter.kicad_pcb]
2017-11-29 母板部の配線を進めた。Display部を決定したいので，中途半端だがcommit。
    [freq-counter.kicad_pcb]
2017-11-29 Display部の配線は完成。
    [freq-counter.kicad_pcb]
2017-11-29 Display 部を決定。これに合わせて母板を設計する。
    [freq-counter.kicad_pcb]
2017-11-29 Display板の大きさ，向きが決まった。Displayに合わせて母板を仕上げる。
    [freq-counter.kicad_pcb]
2017-11-29 Display部に，Hz/RPM用のLEDとPUSH-BUTTONを移動させた。Display部は，本当に完成。
    [freq-counter.kicad_pcb]
2017-11-29 Display 部にLED用の電流制限抵抗を移動させた。Display部のtestをしやすくするため。
    [freq-counter.kicad_pcb, freq-counter.sch]
2017-11-29 1kMGの電流制限抵抗(R1)の配置を水平から垂直に変更。
    [freq-counter.kicad_pcb]
2017-11-29 Display部の Hz/RPM をTerminal接続にした。
    [freq-counter.kicad_pcb, freq-counter.sch]
2017-11-30 Hz/RPM のterminal化が完成。
    他にもpackages3dの設定や，footprintの設定を変えたりするなど。
    余計な手間を掛けていると思える。
    [freq-counter.kicad_pcb, freq-counter.sch]
2017-11-30 1kMG-LED 部のTerminal化が完了。
    [freq-counter.kicad_pcb, freq-counter.sch]
2017-11-30 LED に関してのCvPcbをやり直した。
    [7seg.sch, freq-counter.kicad_pcb, freq-counter.sch]
2017-11-30 transistor には，CvPcbをやり直した。
    [3in8out.sch, 7seg.sch, freq-counter.sch]
2017-11-30 count-up を Terminal 化した。
    [freq-counter.kicad_pcb, freq-counter.sch]
2017-11-30 combine Segments-Terminal? and count-up-Terminal?
    [freq-counter.kicad_pcb, freq-counter.sch]
2017-11-30 余分な配線やビヤを削除。その他，不必要となった箇所を削除。
    [freq-counter.kicad_pcb]
2017-11-30 上階のDisplay部は配線が完了したと考えている。
    あとは，上階のPinHeaderに合わせて，下階のPinSocketを配置して配線を頑張るだけ。
    [freq-counter.kicad_pcb]
2017-11-30 Terminal0 系を配置。
    後は上手く配線をするだけ。
    [freq-counter.kicad_pcb, freq-counter.sch]
2017-11-30 Terminal0系をlock。 Hz/RPMの部品をHz/RPM-Terminal0付近に配置。
    [freq-counter.kicad_pcb]
2017-11-30 基板外形を決定。Terminal0の位置も決定し，Lockしておいた。
    なんとか上手く２階建てにできそう。
    [freq-counter.kicad_pcb]
2017-11-30 １階の母板に実装する部品の位置を決定。
    あとは，１階の配線が決定すれば実装に移れる。
    [freq-counter.kicad_pcb]
2017-11-30 １階の配線の大部分が終了。残るは，ICとTerminal0の配線。
    1kMG LED については，1 <-> k, M <-> G の入れ替えをそれぞれした方が良いと分かった
    ので，次の commit で修正しておく。
    [freq-counter.kicad_pcb]
2017-11-30 SN74HC02N(U1)の，LED_1 <-> LED_k, LED_M <-> LED-G の配線をそれぞれ入れ替えた。
    [freq-counter.kicad_pcb, freq-counter.sch]
2017-11-30 １階・２階・Terminal0 <-> Terminal1 の全てにおいて配線完了。
    [freq-counter.kicad_pcb]
2017-11-30 なんでこんなdiffが？
    [3in8out.sch]
2017-11-30 Power-Digtis_Terminal1 を作成。Power, Digits の Terminal1 を連結させた。
    Connectors_JSTを使っても取り外しを出来るのは，
    １階と２階の基板を離してからだと思ったので近くにいた，Digits系と繋げてしまった。
    こっちの方が強度を出せると思うため。
    [freq-counter.kicad_pcb, freq-counter.sch]
2017-11-30 ほぼ完成。電源ON/OFFの switch を slide switch に変更する必要があるけど保留。
    [freq-counter.kicad_pcb, freq-counter.sch]
2017-11-30 実装には進んで良い板。但し，Silkの向き・位置の修正など細々した修正が必要。
    [freq-counter.kicad_pcb]
2017-11-30 基板画像が汚かったので撮り直した。
2017-12-01 slide switch 1P2T.
2017-12-01 SK-12D01-VG4 (小型 slide switch) の footprint, 3D model 作った。
2017-12-01 SS12D01G4(slide switch) の足が基板から出るように修正。footprint も作成。
2017-12-01 自作の3D modelを使う時，pathを${KIPROJMOD}からの相対pathで指定するようにした。
2017-12-01 3D model のpathを指定する方法を，KIPROJMOD環境変数からの相対pathに変更。
    今までは絶対pathで指定していた。
2017-12-01 KIPRJMOD が正しく， KIPROJMOD は誤り。
2017-12-01 Power ON/OFF switch を slide switch に変更。
    [freq-counter.kicad_pcb, freq-counter.sch]
2017-12-01 RPM on board を PinHeaderに変更。
    手持ちの部品にJST_XH_B03B-XH-A_1x03_P2.50mmの横向きがなかったため。
    [freq-counter.kicad_pcb, freq-counter.sch]
2017-12-01 ON/OFF の slide switch を横型に変更。
    [freq-counter.sch]
2017-12-01 slide switch(横型) の footprint で，3PINが四角だったので，丸に修正。
    [freq-counter.kicad_pcb]
2017-12-01 silk の配置・回転を完了させた。
    [freq-counter.kicad_pcb]
2017-12-01 toggle に関する部品を手前側に移動させて，奥側に空間を用意するようにした。
    後々，電池を配置できればいいなと思っている。
    [freq-counter.kicad_pcb]
2017-12-01 取り急ぎ，基板外形の縦の大きさを１階・２階ともに2.8inchとした。0.1inch縮めた。
    [freq-counter.kicad_pcb]
2017-12-01 基板外形だけは修正している。
    [freq-counter.kicad_pcb]
2017-12-01 基板外形を縦0.1inch縮めた配線を完了。
    しかし，横も0.1inchでかいと気付いてしまった。
    こっちは難しそうだ。
    [freq-counter.kicad_pcb]
2017-12-01 取り急ぎ，基板外形の横を3.7inchとした。横も0.1inch縮めた。
    [freq-counter.kicad_pcb]
2017-12-02 Power ON/OFF の slide switch を横型から縦型に変更。
    [freq-counter.kicad_pcb, freq-counter.sch]
2017-12-02 BarrelJack-DC の footprint が削除されていたので復活させた。
    [freq-counter.kicad_pcb]
2017-12-02 旧式の footprint, packages3D を大復活させた。
2017-12-02 民族大移動。
    [freq-counter.kicad_pcb]
2017-12-02 細々とした配線の最適化を施した。
    [freq-counter.kicad_pcb]
2017-12-02 左辺の基板外形の２階と１階の端点が一致するよう修正。
    基板外形を上手く決定できなくて error を出力していたので
    [freq-counter.kicad_pcb]
2017-12-02 3Dpackages が表示されるように，旧式の3D modelを使うようにした。
    [3in8out.sch, 7seg.sch, freq-counter.kicad_pcb, freq-counter.sch]
2017-12-02 ２階のsilkの整理が終わった。
    [freq-counter.kicad_pcb]
2017-12-02 １階のsilkの修正も完了。
    [freq-counter.kicad_pcb]
2017-12-02 footprint の定数の位置や向きを修正。綺麗になった。良かった。
    実装する時に分かりやすいと思う。
    [freq-counter.kicad_pcb]
2017-12-02 細々とした配線の修正。
    [freq-counter.kicad_pcb]
2017-12-02 clock(Y1) を 20MHz とした。
    [freq-counter.kicad_pcb, freq-counter.sch]
2017-12-02 部品表。
    [freq-counter.ods]
2017-12-02 基板の１階と２階にKiCadのLogoを入れて本当に完成。
    [freq-counter.kicad_pcb]
2017-12-02 忘れ物。
    [freq-counter.kicad_pcb, freq-counter.sch]
2017-12-07 BNC connector(B-057-HP)の大きさに合わせた形を作った。
    case に穴を開ける時に使う。
    参考:
    http://akizukidenshi.com/catalog/g/gC-00134/
2017-12-08 3mm hole.
2017-12-08 完成した基板と，image board by KiCad .
2017-12-08 almost done. caseが粗方完成。
2017-12-09 細々した部品を書いている。stoodとか。押しbuttonとか。
    残りは，前面の Signal/RPM 切り替え用の bar くらい。
2017-12-09 make a cube with hight of 10mm board.
2017-12-09 1面と3面の両脇のホゾが完成。
2017-12-09 5, 6面のホゾを作成。
2017-12-09 BNC connector design.
2017-12-09 freq-counter のcaseが完成。
2017-12-09 EE-SX640 を使ってRPM計測する時のために，右側にcaseを作った。
2017-12-09 空いている部分にcube用のpieceを作った。
2017-12-10 Hz/RPM切り替え用のswitch()を切り出すようにした。空き場所にblockを作った。
    この板で切ってしまう。
2018-07-24 KiCad 5.0 change some files.
    [3in8out.sch, 7seg.sch, freq-counter.sch]
